AsterDW/Voron/PrinterMods/Skirt_Side_ScrewOn_Fans/Models/HexCover/Hex Fan Grill.3mf

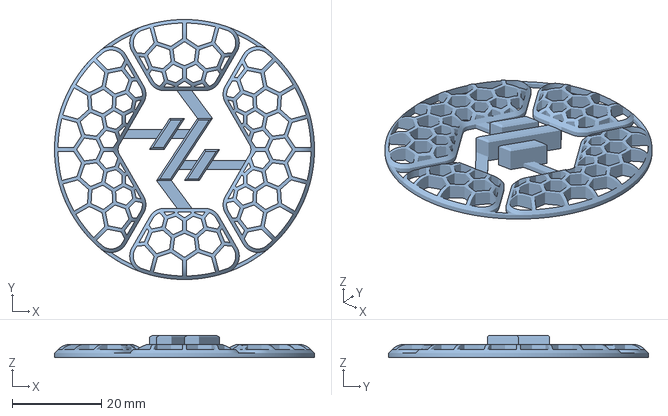
[picture p1: CAD file, 2021-12-13]
PrinterMods/Skirt_Side_ScrewOn_Fans/Models/HexCover/Hex Fan Grill.3mf
58.4 x 58.4 x 5.00 mm
