AsterDW/Voron/PrinterMods/Skirt_Side_ScrewOn_Fans/Models/side_screw_on_fan_support_x2.3mf

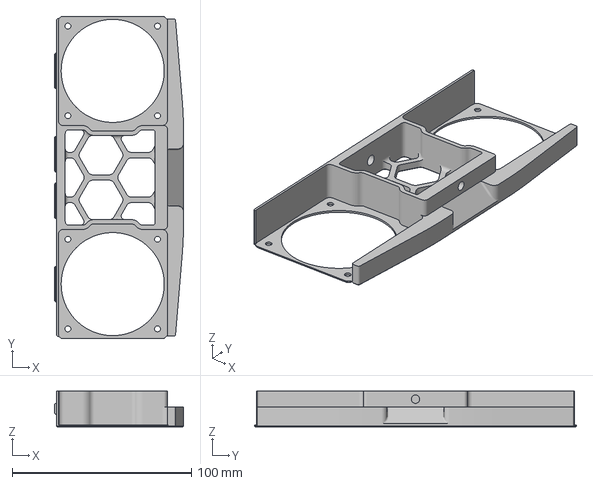
[picture p2: CAD file, 2021-12-13]
PrinterMods/Skirt_Side_ScrewOn_Fans/Models/side_screw_on_fan_support_x2.3mf
72.0 x 180.0 x 20.0 mm
