AsterDW/Voron/PrinterMods/Skirt_Side_ScrewOn_Fans/Models/SquareCover/Fan Cover.3mf

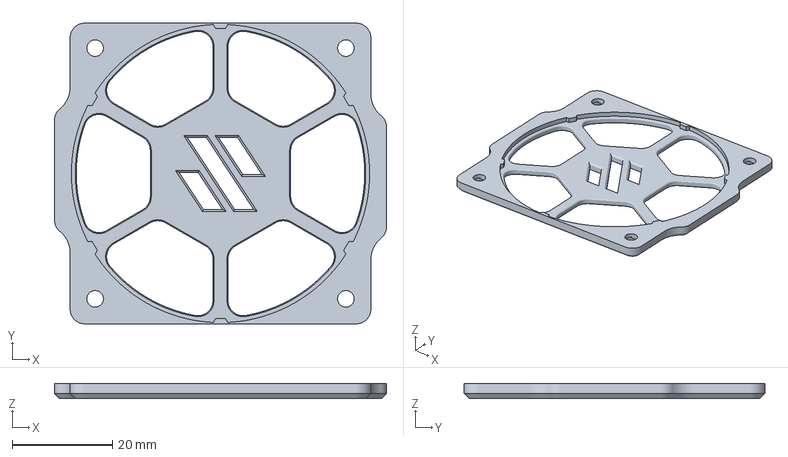
[picture p3: CAD file, 2021-12-13]
PrinterMods/Skirt_Side_ScrewOn_Fans/Models/SquareCover/Fan Cover.3mf
66.2 x 60.0 x 3.00 mm
