AsterDW/Voron/PrinterMods/Skirt_Side_ScrewOn_Fans/Models/HexCover/Hex Side Fan Cover.3mf

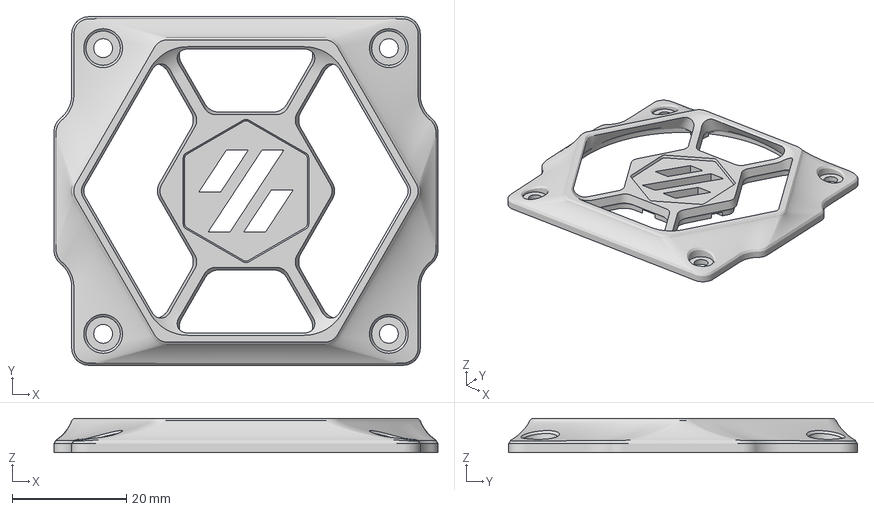
[picture p4: CAD file, 2021-12-13]
PrinterMods/Skirt_Side_ScrewOn_Fans/Models/HexCover/Hex Side Fan Cover.3mf
67.2 x 61.0 x 6.00 mm
