AsterDW/Voron/PrinterMods/Skirt_Side_ScrewOn_Fans/Models/SquareCover/Grill Ring.3mf

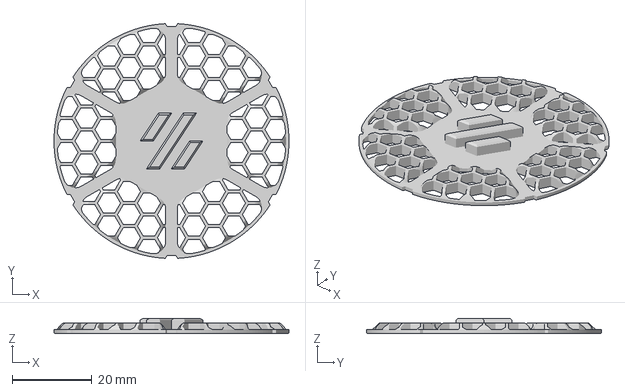
[picture p5: CAD file, 2021-12-13]
PrinterMods/Skirt_Side_ScrewOn_Fans/Models/SquareCover/Grill Ring.3mf
59.1 x 59.0 x 3.80 mm
