AsterDW/Voron/PrinterMods/Skirt_Side_ScrewOn_Fans/Images/Hex Style Printed.jpg

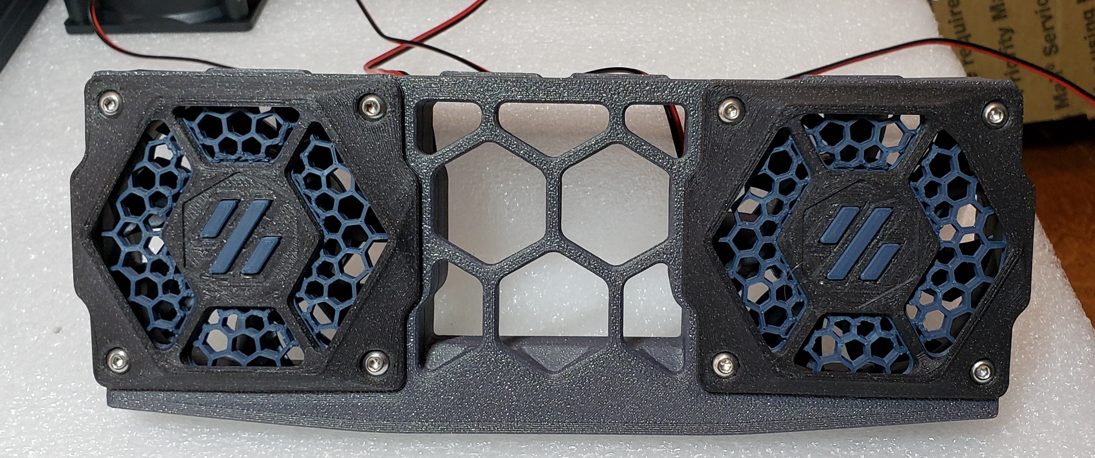
PrinterMods/Skirt_Side_ScrewOn_Fans/Images/Hex Style Printed.jpg
