AsterDW/Voron/(commit log)

2021-12-13 Side Screw On Fan Mount mod added
    Initial Checkin of Screw Mount Side Fans
    [Fan Cover.3mf, Grill Ring.3mf, Hex Fan Grill.3mf, Hex Side Fan Cover.3mf, side_screw_on_fan_support_x2.3mf]
2021-12-13 Replaced old image of threaded fan mount
    Used updated image with M3 x 22mm screws
